uamt-brno/canshark/README.md

canshark
========

Wireshark sniffer for CAN bus
