uamt-brno/canshark/pcb/CanSharkV20/CanSharkV20.brd

## EAGLE design pcb/CanSharkV20/CanSharkV20.brd (2014-06-05)

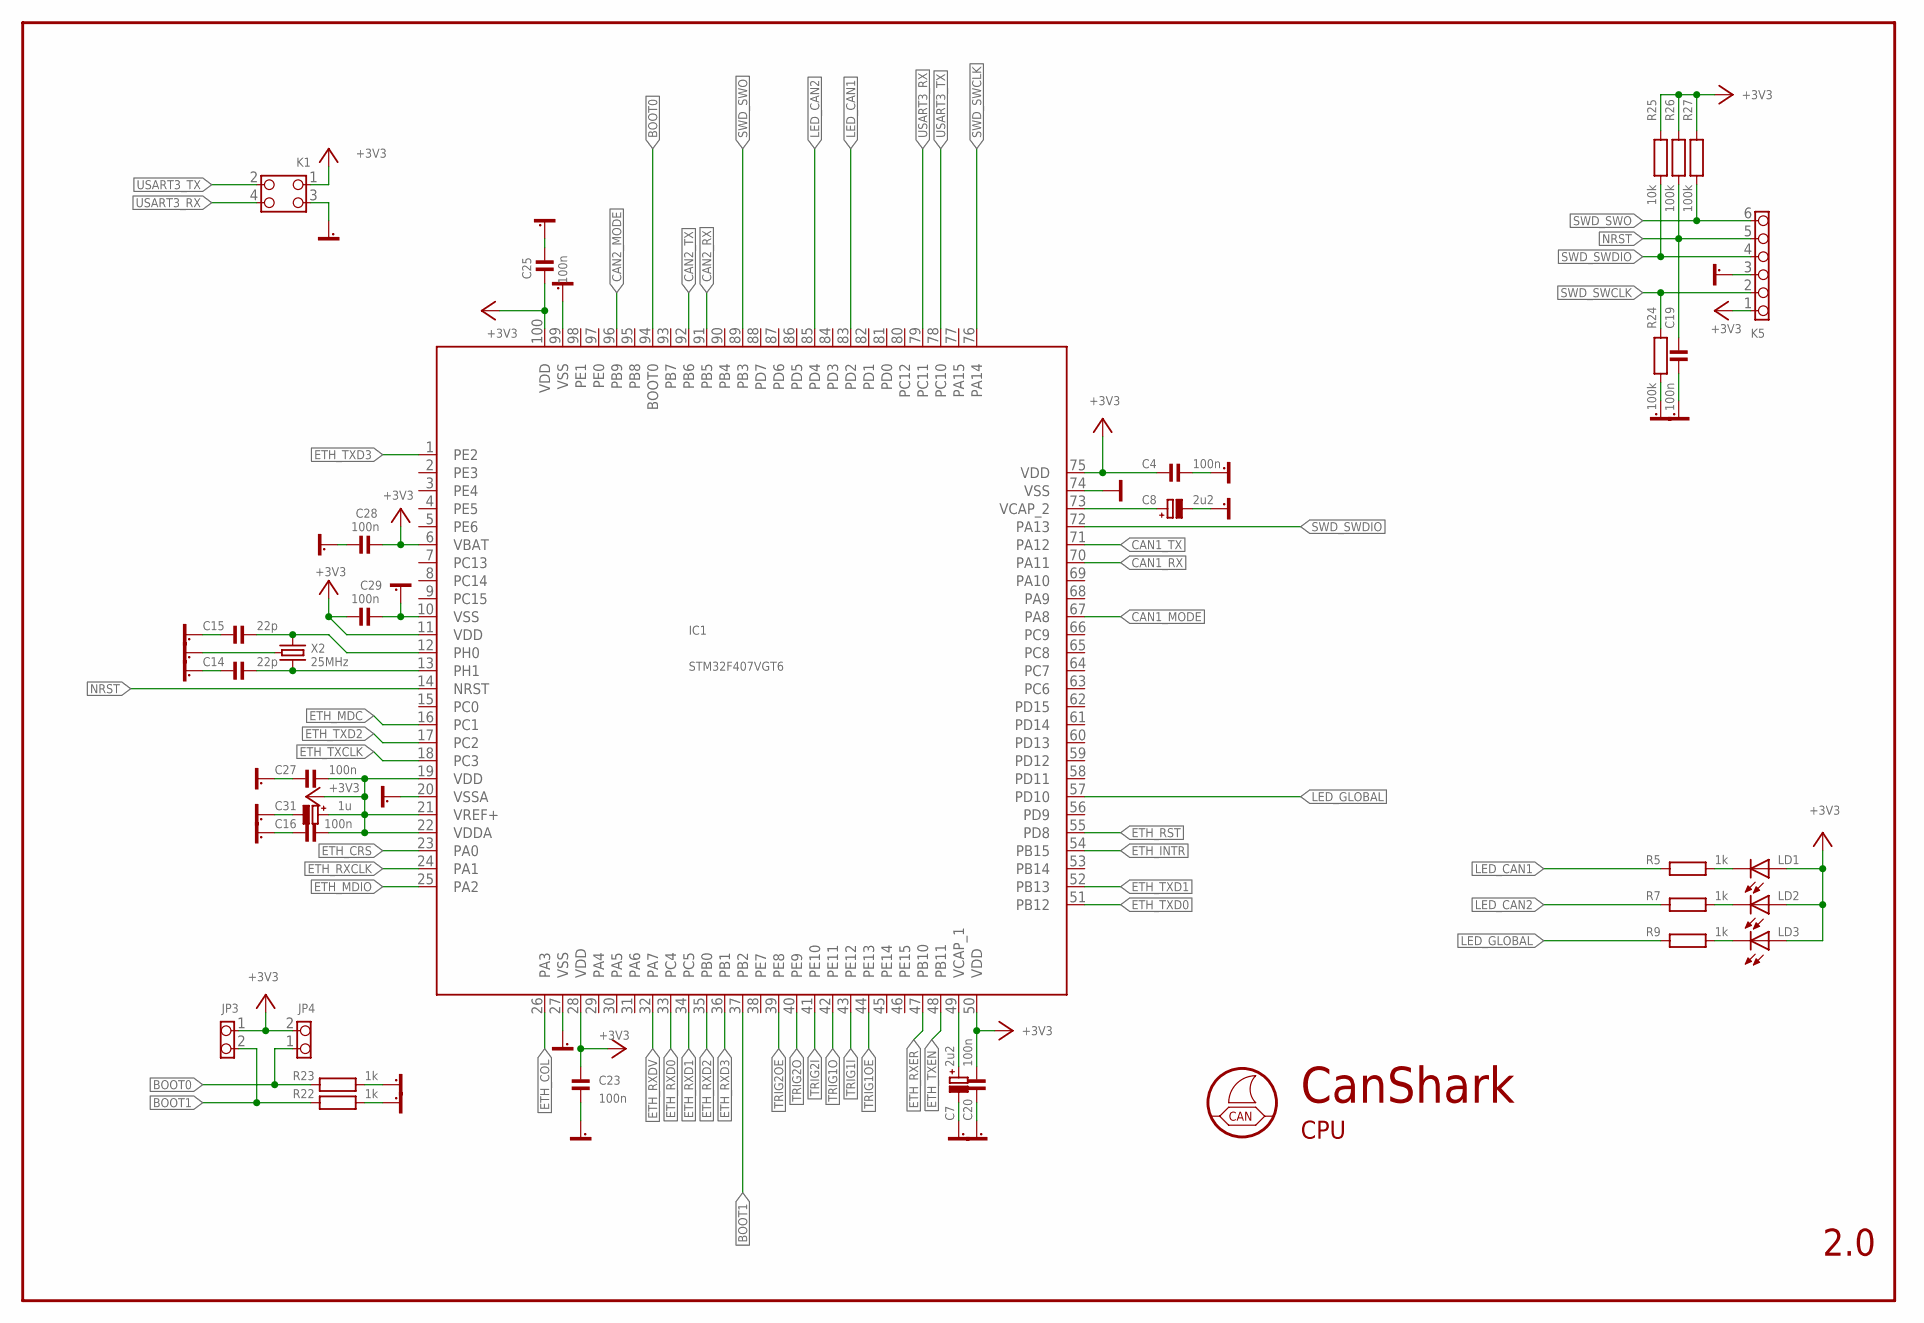
[picture p1: schematic CanSharkV20.sch, sheet 1]

Parts:
C4, C16, C19, C20, C23, C25, C27, C28, C29: 100n; 0603
C7, C8: 2u2; CT3216A
C14, C15: 22p; 0603
C31: 1u; CT3216A
IC1: STM32F407VGT6; LQFP100
JP3, JP4: PINHD-1X2; 1X02_254
K1: PINHD-2X2; 2X02_254
K5: PINHD-1X6; 1X06_254
LD1, LD2, LD3: TLLG4400; LED3MM
R5, R7, R9, R22, R23: 1k; 0603
R24, R25, R27: 100k; 0603
R26: 10k; 0603
X2: 25MHz; X_XT324

Connections:
+3V3: C4.2, C16.1, C20.1, C23.1, C25.2, C27.1, C28.2, C29.2, C31.+, IC1.6 (VBAT), IC1.11 (VDD), IC1.19 (VDD), IC1.21 (VREF+), IC1.22 (VDDA), IC1.28 (VDD), IC1.50 (VDD), IC1.75 (VDD), IC1.100 (VDD), JP3.1, JP4.2, K1.1, K5.1, LD1.A, LD2.A, LD3.A, R25.1, R26.2, R27.1; also elsewhere on the board
BOOT0: IC1.94 (BOOT0), JP4.1, R23.2
BOOT1: IC1.37 (PB2), JP3.2, R22.2
CAN1_MODE: IC1.67 (PA8); also elsewhere on the board
CAN1_RX: IC1.70 (PA11); also elsewhere on the board
CAN1_TX: IC1.71 (PA12); also elsewhere on the board
CAN2_MODE: IC1.96 (PB9); also elsewhere on the board
CAN2_RX: IC1.91 (PB5); also elsewhere on the board
CAN2_TX: IC1.92 (PB6); also elsewhere on the board
ETH_COL: IC1.26 (PA3); also elsewhere on the board
ETH_CRS: IC1.23 (PA0); also elsewhere on the board
ETH_INTR: IC1.54 (PB15); also elsewhere on the board
ETH_MDC: IC1.16 (PC1); also elsewhere on the board
ETH_MDIO: IC1.25 (PA2); also elsewhere on the board
ETH_RST: IC1.55 (PD8); also elsewhere on the board
ETH_RXCLK: IC1.24 (PA1); also elsewhere on the board
ETH_RXD0: IC1.33 (PC4); also elsewhere on the board
ETH_RXD1: IC1.34 (PC5); also elsewhere on the board
ETH_RXD2: IC1.35 (PB0); also elsewhere on the board
ETH_RXD3: IC1.36 (PB1); also elsewhere on the board
ETH_RXDV: IC1.32 (PA7); also elsewhere on the board
ETH_RXER: IC1.47 (PB10); also elsewhere on the board
ETH_TXCLK: IC1.18 (PC3); also elsewhere on the board
ETH_TXD0: IC1.51 (PB12); also elsewhere on the board
ETH_TXD1: IC1.52 (PB13); also elsewhere on the board
ETH_TXD2: IC1.17 (PC2); also elsewhere on the board
ETH_TXD3: IC1.1 (PE2); also elsewhere on the board
ETH_TXEN: IC1.48 (PB11); also elsewhere on the board
GND: IC1.74 (VSS)
GND1: C4.1, C7.-, C8.-, C14.2, C15.2, C16.2, C19.2, C20.2, C23.2, C25.1, C27.2, C28.1, C29.1, C31.-, IC1.10 (VSS), IC1.20 (VSSA), IC1.27 (VSS), IC1.99 (VSS), K1.3, K5.3, R22.1, R23.1, R24.2, X2.2 (G), X2.4 (G); also elsewhere on the board
LED_CAN1: IC1.83 (PD2), R5.2
LED_CAN2: IC1.85 (PD4), R7.2
LED_GLOBAL: IC1.57 (PD10), R9.2
unnamed: C7.+, IC1.49 (VCAP_1)
unnamed: C8.+, IC1.73 (VCAP_2)
unnamed: LD1.K (C), R5.1
unnamed: LD2.K (C), R7.1
unnamed: LD3.K (C), R9.1
NRST: C19.1, IC1.14 (NRST), K5.5, R26.1
OSC_IN: C15.1, IC1.12 (PH0), X2.1
OSC_OUT: C14.1, IC1.13 (PH1), X2.3 (2)
SWD_SWCLK: IC1.76 (PA14), K5.2, R24.1
SWD_SWDIO: IC1.72 (PA13), K5.4, R25.2
SWD_SWO: IC1.89 (PB3), K5.6, R27.2
TRIG1I: IC1.43 (PE12); also elsewhere on the board
TRIG1O: IC1.42 (PE11); also elsewhere on the board
TRIG1OE: IC1.44 (PE13); also elsewhere on the board
TRIG2I: IC1.41 (PE10); also elsewhere on the board
TRIG2O: IC1.40 (PE9); also elsewhere on the board
TRIG2OE: IC1.39 (PE8); also elsewhere on the board
USART3_RX: IC1.79 (PC11), K1.4
USART3_TX: IC1.78 (PC10), K1.2

Notes on the sheet:
CAN
2.0
CanShark
CPU

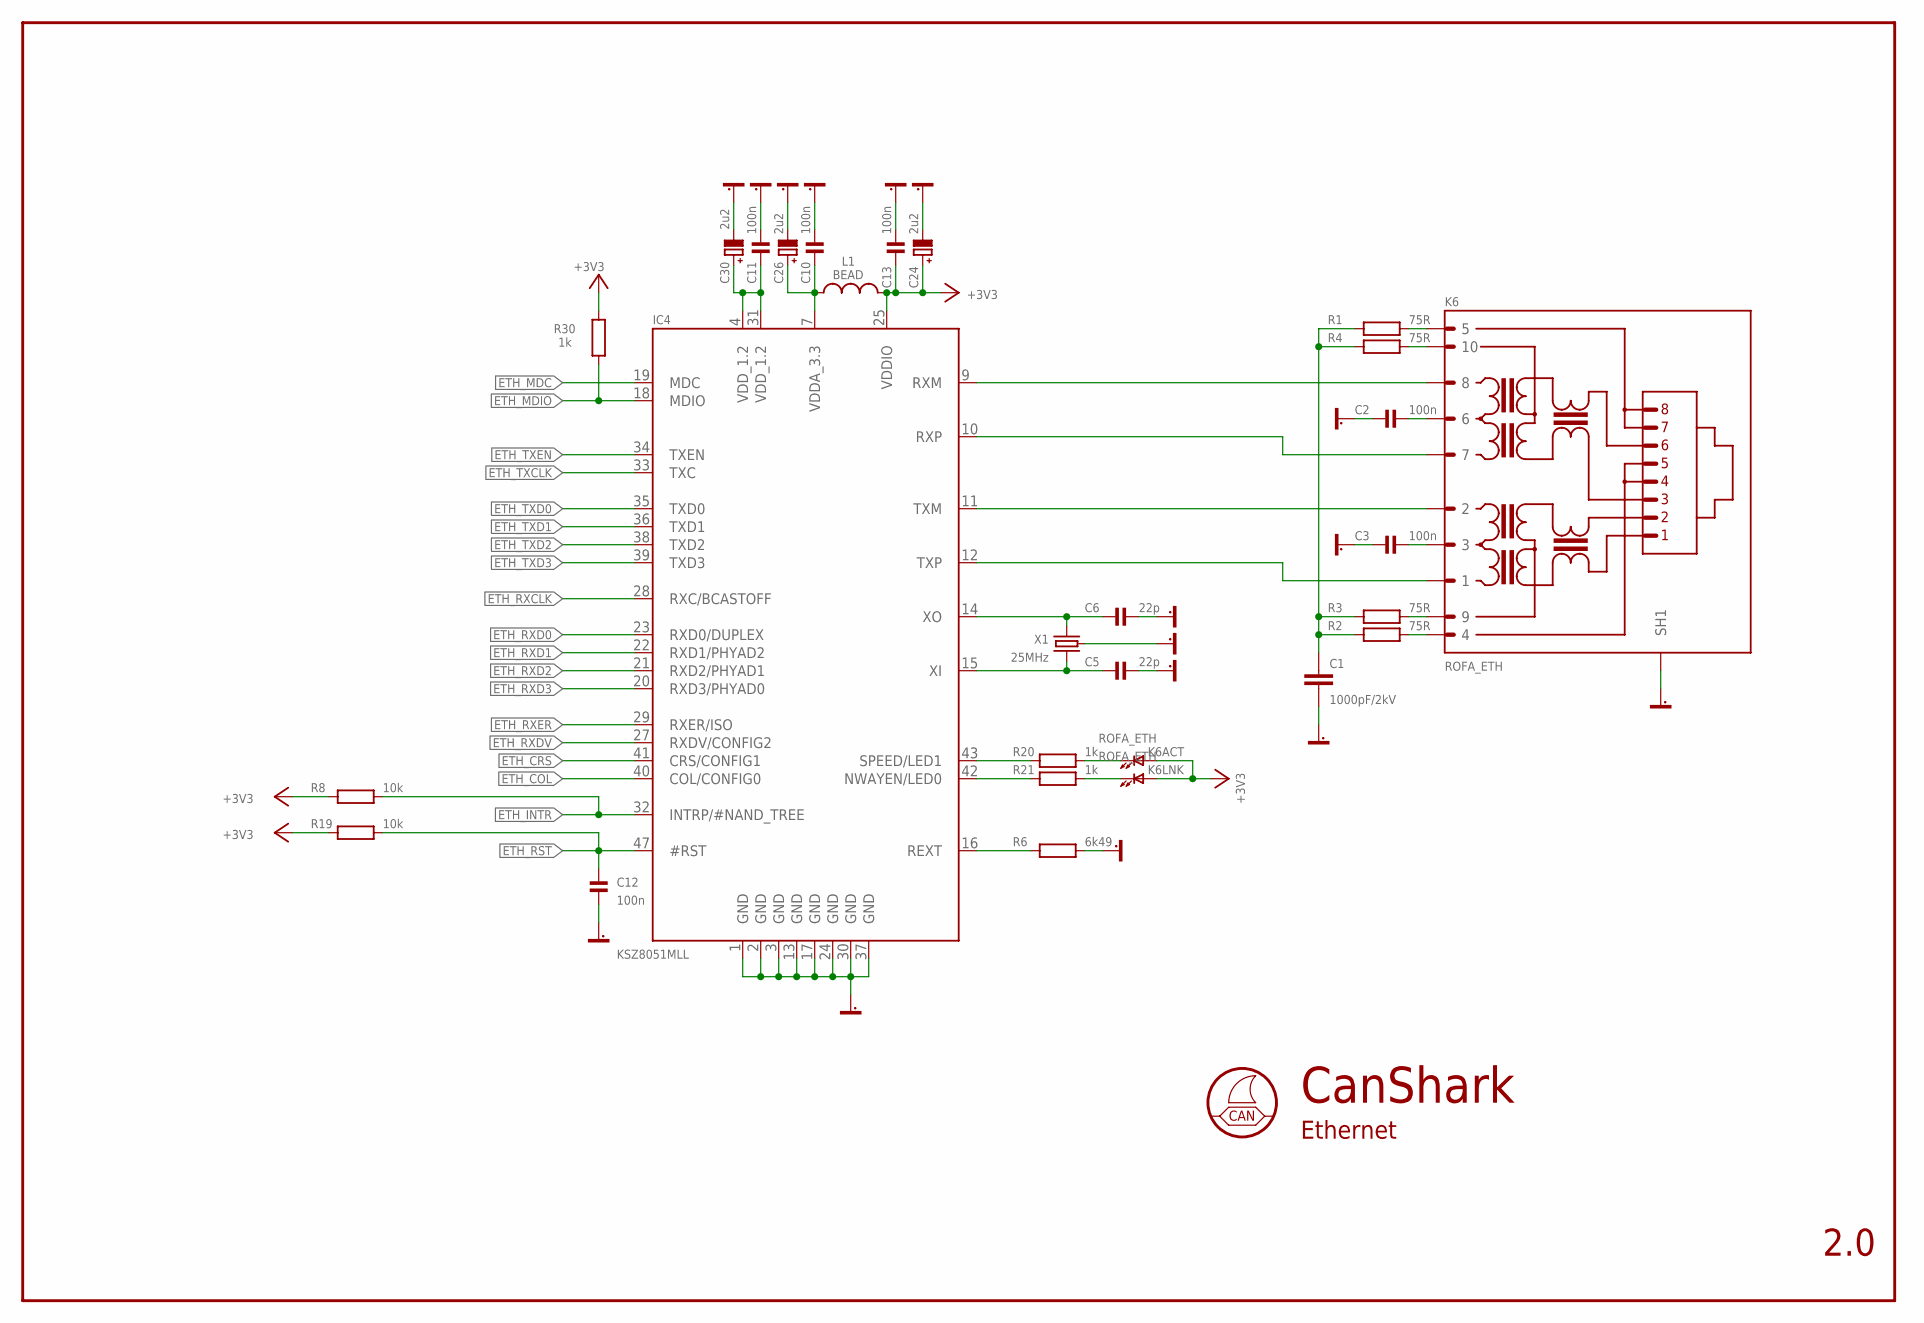
[picture p2: schematic CanSharkV20.sch, sheet 2]

Parts:
C1: 1000pF/2kV; SMD1206
C2, C3, C10, C11, C12, C13: 100n; 0603
C5, C6: 22p; 0603
C24, C26, C30: 2u2; CT3216A
IC4: KSZ8051MLL; LQFP48
K6: ROFA_ETH; RJ45_TRAFO
L1: BEAD; 1206
R1, R2, R3, R4: 75R; 0603
R6: 6k49; 0603
R8, R19: 10k; 0603
R20, R21, R30: 1k; 0603
X1: 25MHz; X_XT324

Connections:
+3V3: C13.2, C24.+, IC4.25 (VDDIO), K6.A_G (A), K6.A_Y (A), L1.1, R8.1, R19.1, R30.2; also elsewhere on the board
ETH_COL: IC4.40 (COL/CONFIG0); also elsewhere on the board
ETH_CRS: IC4.41 (CRS/CONFIG1); also elsewhere on the board
ETH_INTR: IC4.32 (INTRP/#NAND_TREE), R8.2; also elsewhere on the board
ETH_MDC: IC4.19 (MDC); also elsewhere on the board
ETH_MDIO: IC4.18 (MDIO), R30.1; also elsewhere on the board
ETH_RST: C12.1, IC4.47 (#RST), R19.2; also elsewhere on the board
ETH_RXCLK: IC4.28 (RXC/BCASTOFF); also elsewhere on the board
ETH_RXD0: IC4.23 (RXD0/DUPLEX); also elsewhere on the board
ETH_RXD1: IC4.22 (RXD1/PHYAD2); also elsewhere on the board
ETH_RXD2: IC4.21 (RXD2/PHYAD1); also elsewhere on the board
ETH_RXD3: IC4.20 (RXD3/PHYAD0); also elsewhere on the board
ETH_RXDV: IC4.27 (RXDV/CONFIG2); also elsewhere on the board
ETH_RXER: IC4.29 (RXER/ISO); also elsewhere on the board
ETH_TXCLK: IC4.33 (TXC); also elsewhere on the board
ETH_TXD0: IC4.35 (TXD0); also elsewhere on the board
ETH_TXD1: IC4.36 (TXD1); also elsewhere on the board
ETH_TXD2: IC4.38 (TXD2); also elsewhere on the board
ETH_TXD3: IC4.39 (TXD3); also elsewhere on the board
ETH_TXEN: IC4.34 (TXEN); also elsewhere on the board
GND1: C1.2, C2.1, C3.1, C5.1, C6.1, C10.1, C11.1, C12.2, C13.1, C24.-, C26.-, C30.-, IC4.1 (GND), IC4.2 (GND), IC4.3 (GND), IC4.13 (GND), IC4.17 (GND), IC4.24 (GND), IC4.30 (GND), IC4.37 (GND), K6.SH1, K6.SH2 (SH1), R6.1, X1.2 (G), X1.4 (G); also elsewhere on the board
unnamed: K6.K_Y (K), R20.2
unnamed: K6.K_G (K), R21.2
unnamed: C10.2, C26.+, IC4.7 (VDDA_3.3), L1.2
unnamed: C11.2, C30.+, IC4.4 (VDD_1.2), IC4.31 (VDD_1.2)
unnamed: IC4.9 (RXM), K6.8
unnamed: IC4.10 (RXP), K6.7
unnamed: IC4.11 (TXM), K6.2
unnamed: IC4.12 (TXP), K6.1
unnamed: K6.4, R2.2
unnamed: K6.9, R3.2
unnamed: K6.10, R4.2
unnamed: K6.5, R1.2
unnamed: C1.1, R1.1, R2.1, R3.1, R4.1
unnamed: C2.2, K6.6
unnamed: C3.2, K6.3
unnamed: IC4.16 (REXT), R6.2
unnamed: IC4.42 (NWAYEN/LED0), R21.1
unnamed: IC4.43 (SPEED/LED1), R20.1
unnamed: C6.2, IC4.14 (XO), X1.3 (2)
unnamed: C5.2, IC4.15 (XI), X1.1

Notes on the sheet:
CAN
2.0
CanShark
Ethernet

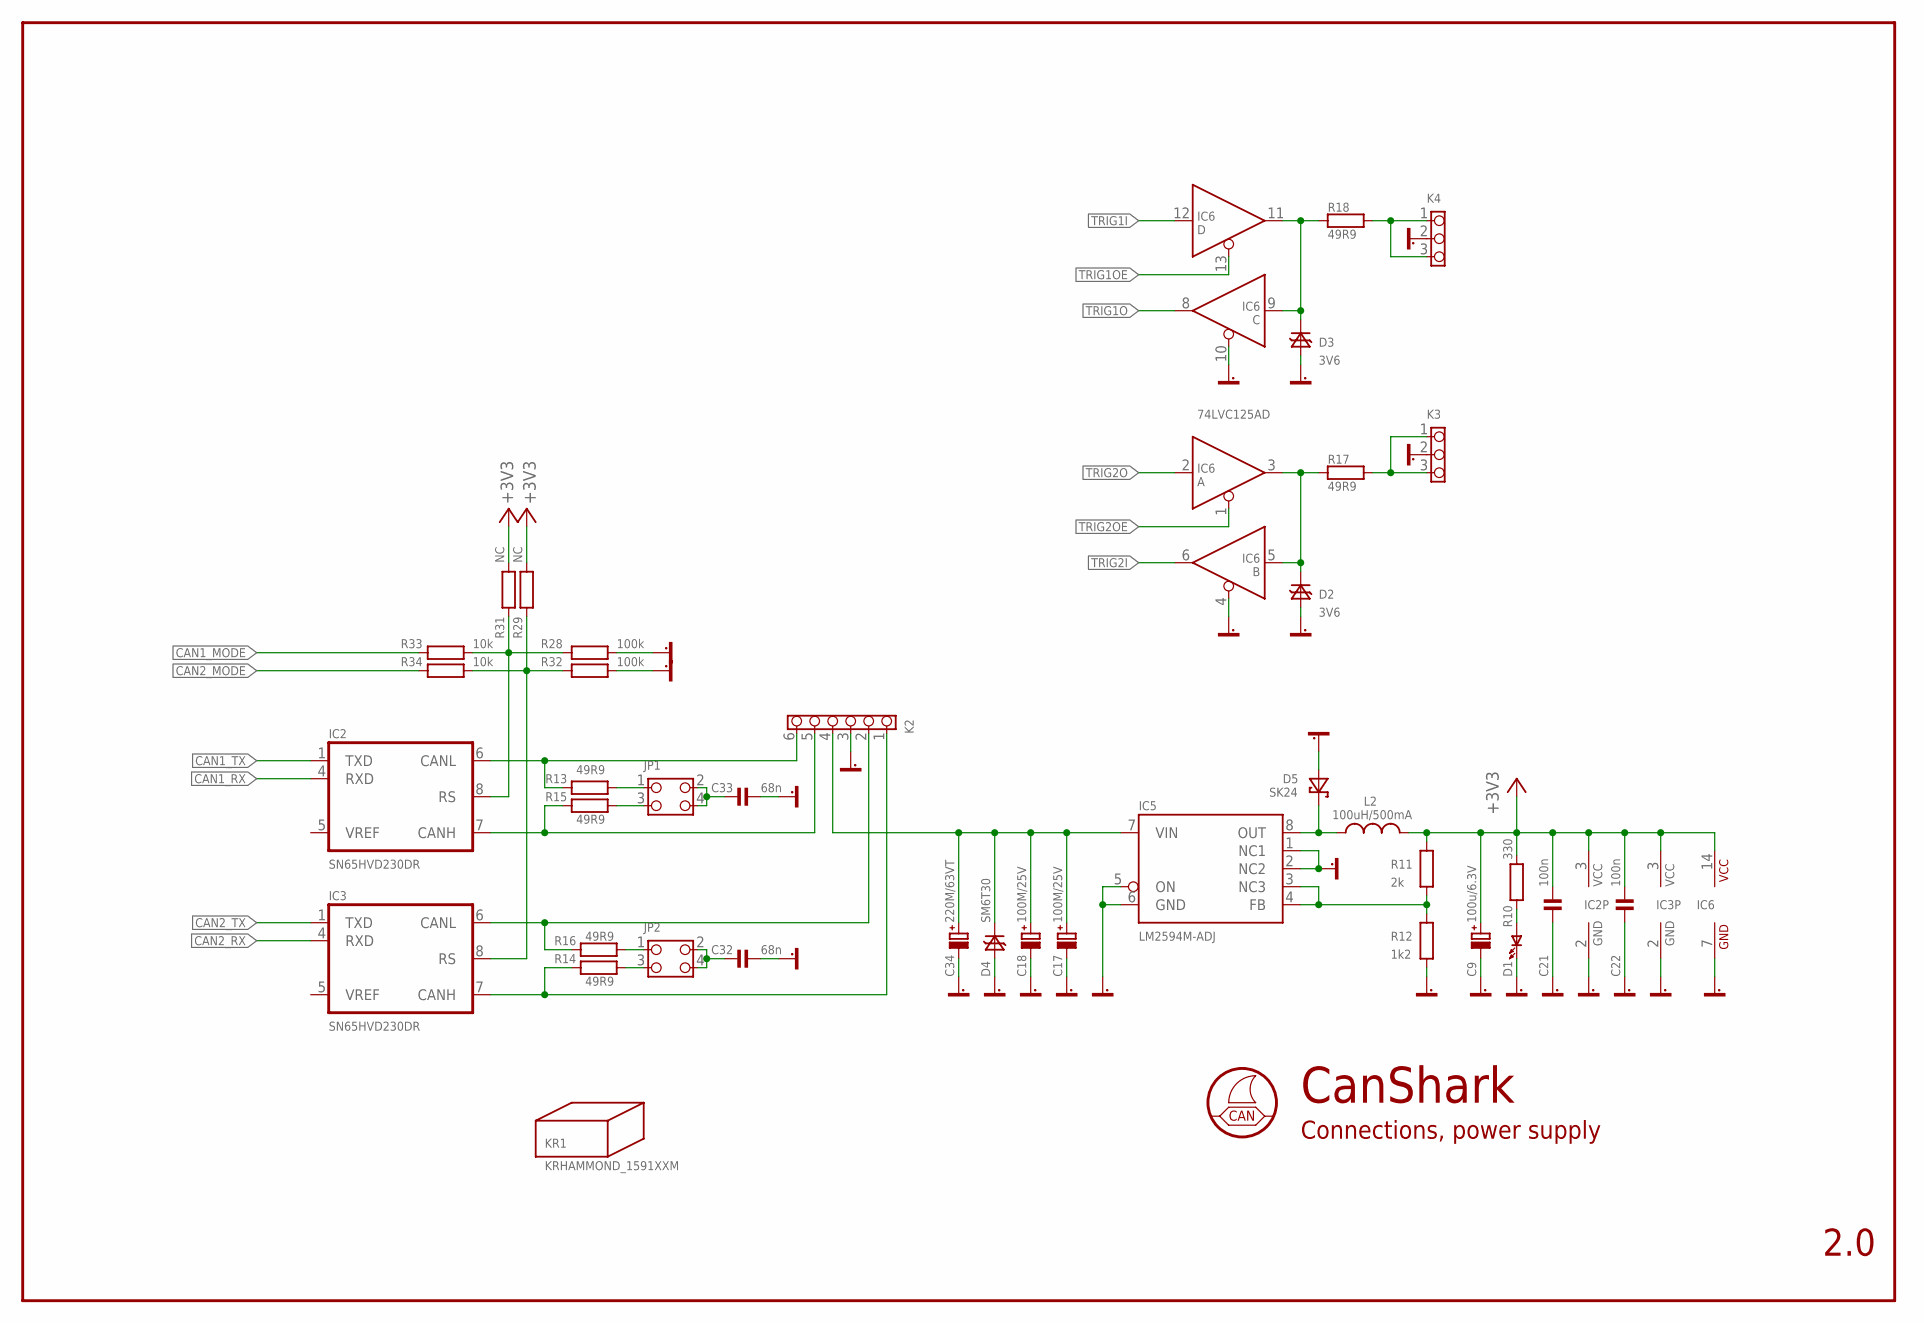
[picture p3: schematic CanSharkV20.sch, sheet 3]

Parts:
C9: 100u/6.3V; CT3528B
C17, C18: 100M/25V; CT7343D
C21, C22: 100n; 0603
C32, C33: 68n; 0805
C34: 220M/63VT; CE_D10L13_R
D1: LED0805; LED_0805
D2, D3: 3V6; D_SMA
D4: SM6T30; D_SMB
D5: SK24; D_SMB
IC2, IC3: SN65HVD230DR; SO08
IC5: LM2594M-ADJ; SO08
IC6: 74LVC125AD; SO14
JP1, JP2: PINHD-2X2_254_EDGE; 2X02_254_EDGE
K2: PINHD-1X6_381_V; 1X06_381_V
K3, K4: PINHD-1X3; 1X03_254
KR1: KRHAMMOND_1591XXM; HAMMOND_1591XXM
L2: 100uH/500mA; L_MLC12XX
R10: 330; 0603
R11: 2k; 0603
R12: 1k2; 0603
R13, R14, R15, R16, R17, R18: 49R9; 0805
R28, R32: 100k; 0603
R29, R31: NC; 0603
R33, R34: 10k; 0603

Connections:
+3V3: C9.+, C21.1, C22.1, IC2.3 (VCC), IC3.3 (VCC), IC6.14 (VCC), L2.2 (1), R10.1, R11.1, R29.1, R31.1; also elsewhere on the board
CAN1_H: IC2.7 (CANH), K2.5, R15.2
CAN1_L: IC2.6 (CANL), K2.6, R13.2
CAN1_MODE: R33.1; also elsewhere on the board
CAN1_RX: IC2.4 (RXD); also elsewhere on the board
CAN1_TX: IC2.1 (TXD); also elsewhere on the board
CAN2_H: IC3.7 (CANH), K2.1, R14.2
CAN2_L: IC3.6 (CANL), K2.2, R16.2
CAN2_MODE: R34.1; also elsewhere on the board
CAN2_RX: IC3.4 (RXD); also elsewhere on the board
CAN2_TX: IC3.1 (TXD); also elsewhere on the board
EXTSUPPLY: C17.+, C18.+, C34.P (+), D4.K, IC5.7 (VIN), K2.4
GND1: C9.-, C17.-, C18.-, C21.2, C22.2, C32.1, C33.1, C34.M (-), D1.K (C), D2.A, D3.A, D4.A, D5.A, IC2.2 (GND), IC3.2 (GND), IC5.1 (NC1), IC5.2 (NC2), IC5.5 (ON), IC5.6 (GND), IC6.4 (OE), IC6.7 (GND), IC6.10 (OE), K2.3, K3.2, K4.2, R12.2, R28.2, R32.2; also elsewhere on the board
unnamed: D2.K, IC6.3 (Y), IC6.5 (A), R17.1
unnamed: JP2.1, R16.1
unnamed: D1.A, R10.2
unnamed: JP2.3, R14.1
unnamed: C32.2, JP2.2, JP2.4
unnamed: IC2.8 (RS), R28.1, R31.2, R33.2
unnamed: JP1.1, R13.1
unnamed: IC3.8 (RS), R29.2, R32.1, R34.2
unnamed: JP1.3, R15.1
unnamed: C33.2, JP1.2, JP1.4
unnamed: K4.1, K4.3, R18.2
unnamed: K3.1, K3.3, R17.2
unnamed: D5.K, IC5.8 (OUT), L2.1 (2)
unnamed: IC5.3 (NC3), IC5.4 (FB), R11.2, R12.1
unnamed: D3.K, IC6.9 (A), IC6.11 (Y), R18.1
TRIG1I: IC6.12 (A); also elsewhere on the board
TRIG1O: IC6.8 (Y); also elsewhere on the board
TRIG1OE: IC6.13 (OE); also elsewhere on the board
TRIG2I: IC6.6 (Y); also elsewhere on the board
TRIG2O: IC6.2 (A); also elsewhere on the board
TRIG2OE: IC6.1 (OE); also elsewhere on the board

Notes on the sheet:
CAN
2.0
CanShark
Connections, power supply

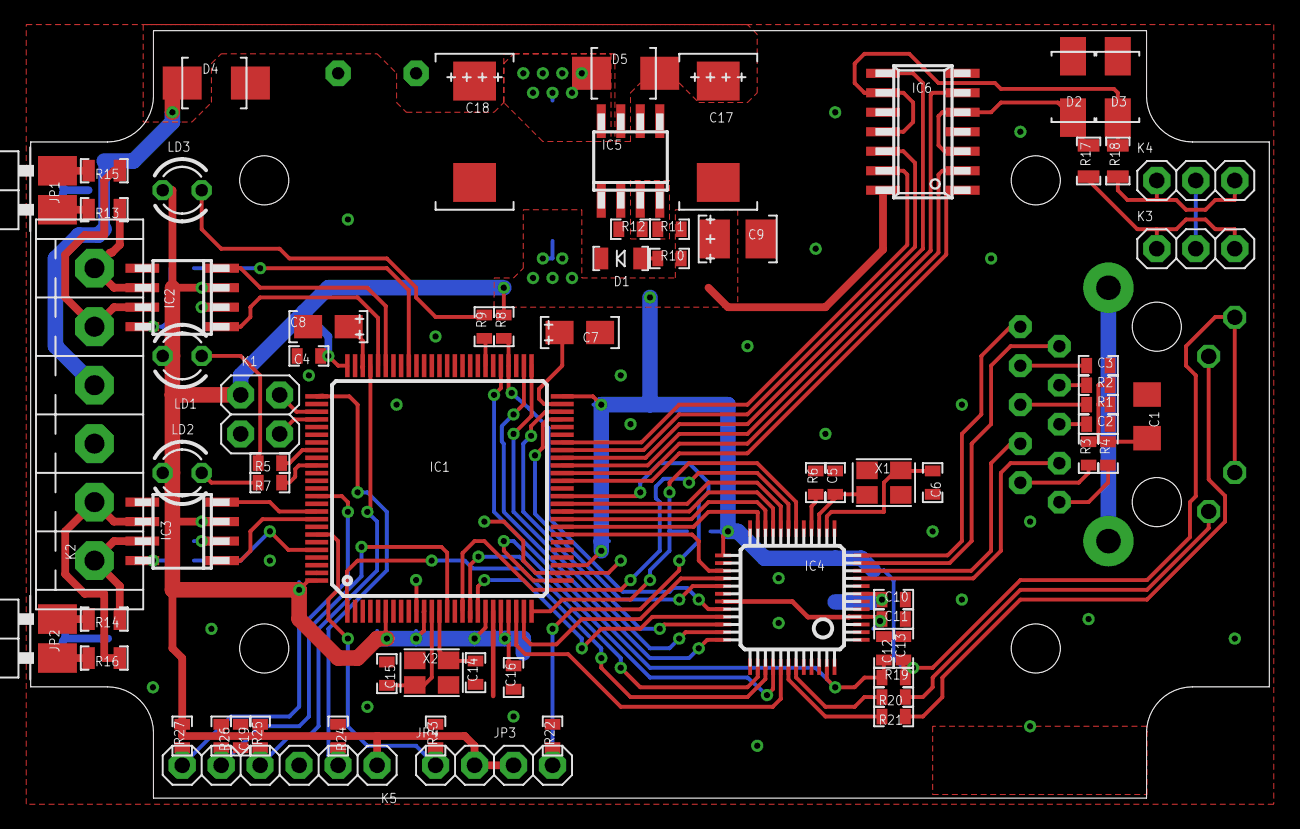
[picture p4: board CanSharkV20.brd from above]

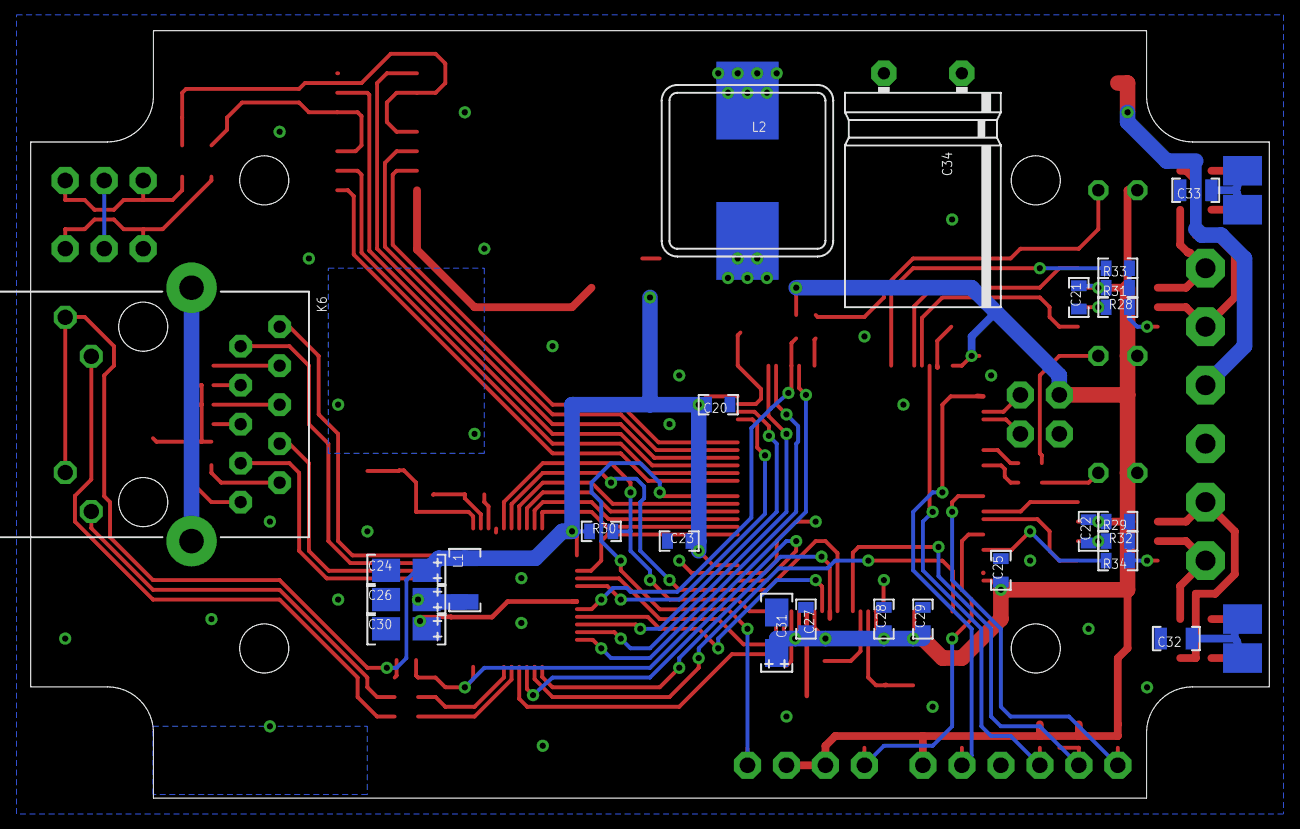
[picture p5: board CanSharkV20.brd from below]

Board: 2 copper layers, 80.7 x 50.0 mm, 97 parts (25 on the bottom side), 91 nets.
