uamt-brno/canshark/pcb/F407-v10/CanShark.brd

## EAGLE design pcb/F407-v10/CanShark.brd (2014-06-02)

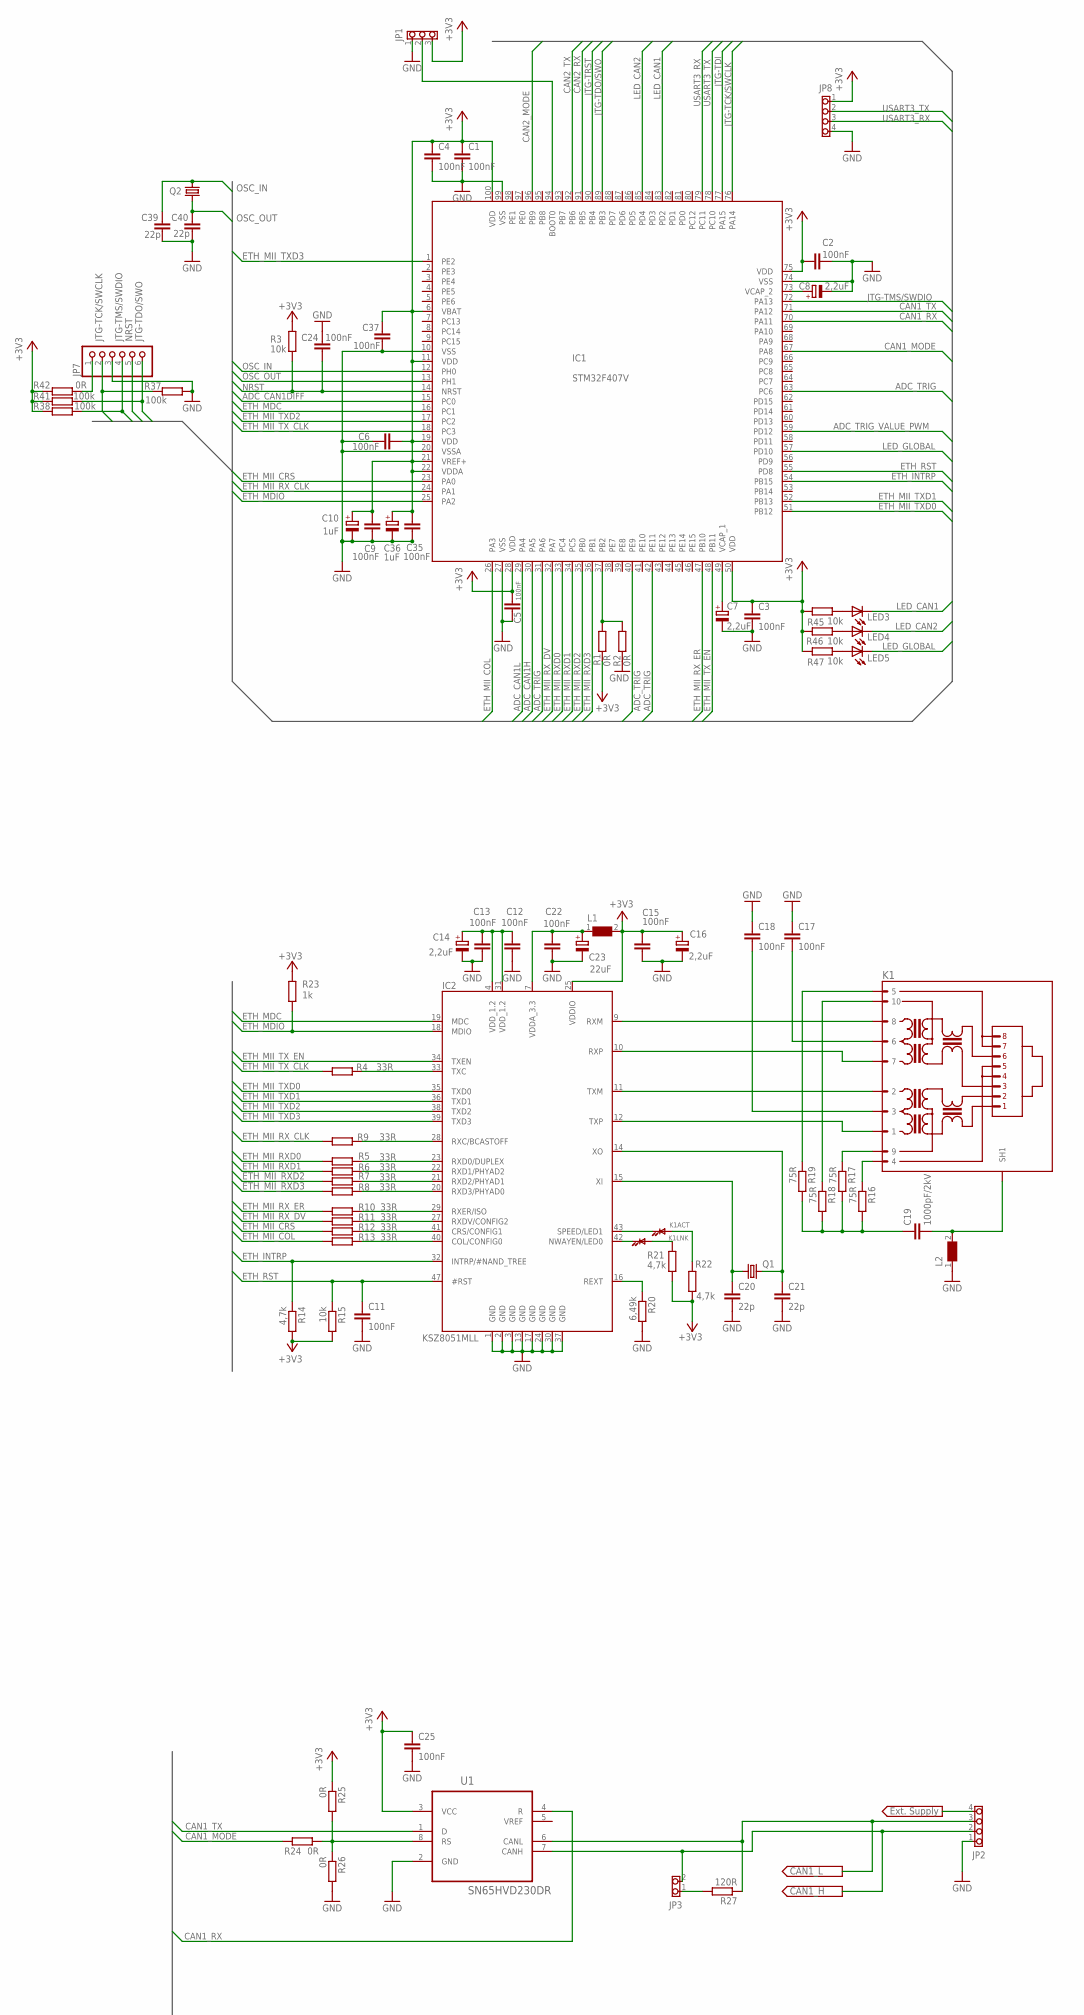
[picture p6: schematic CanShark.sch, part in row 1, column 1]

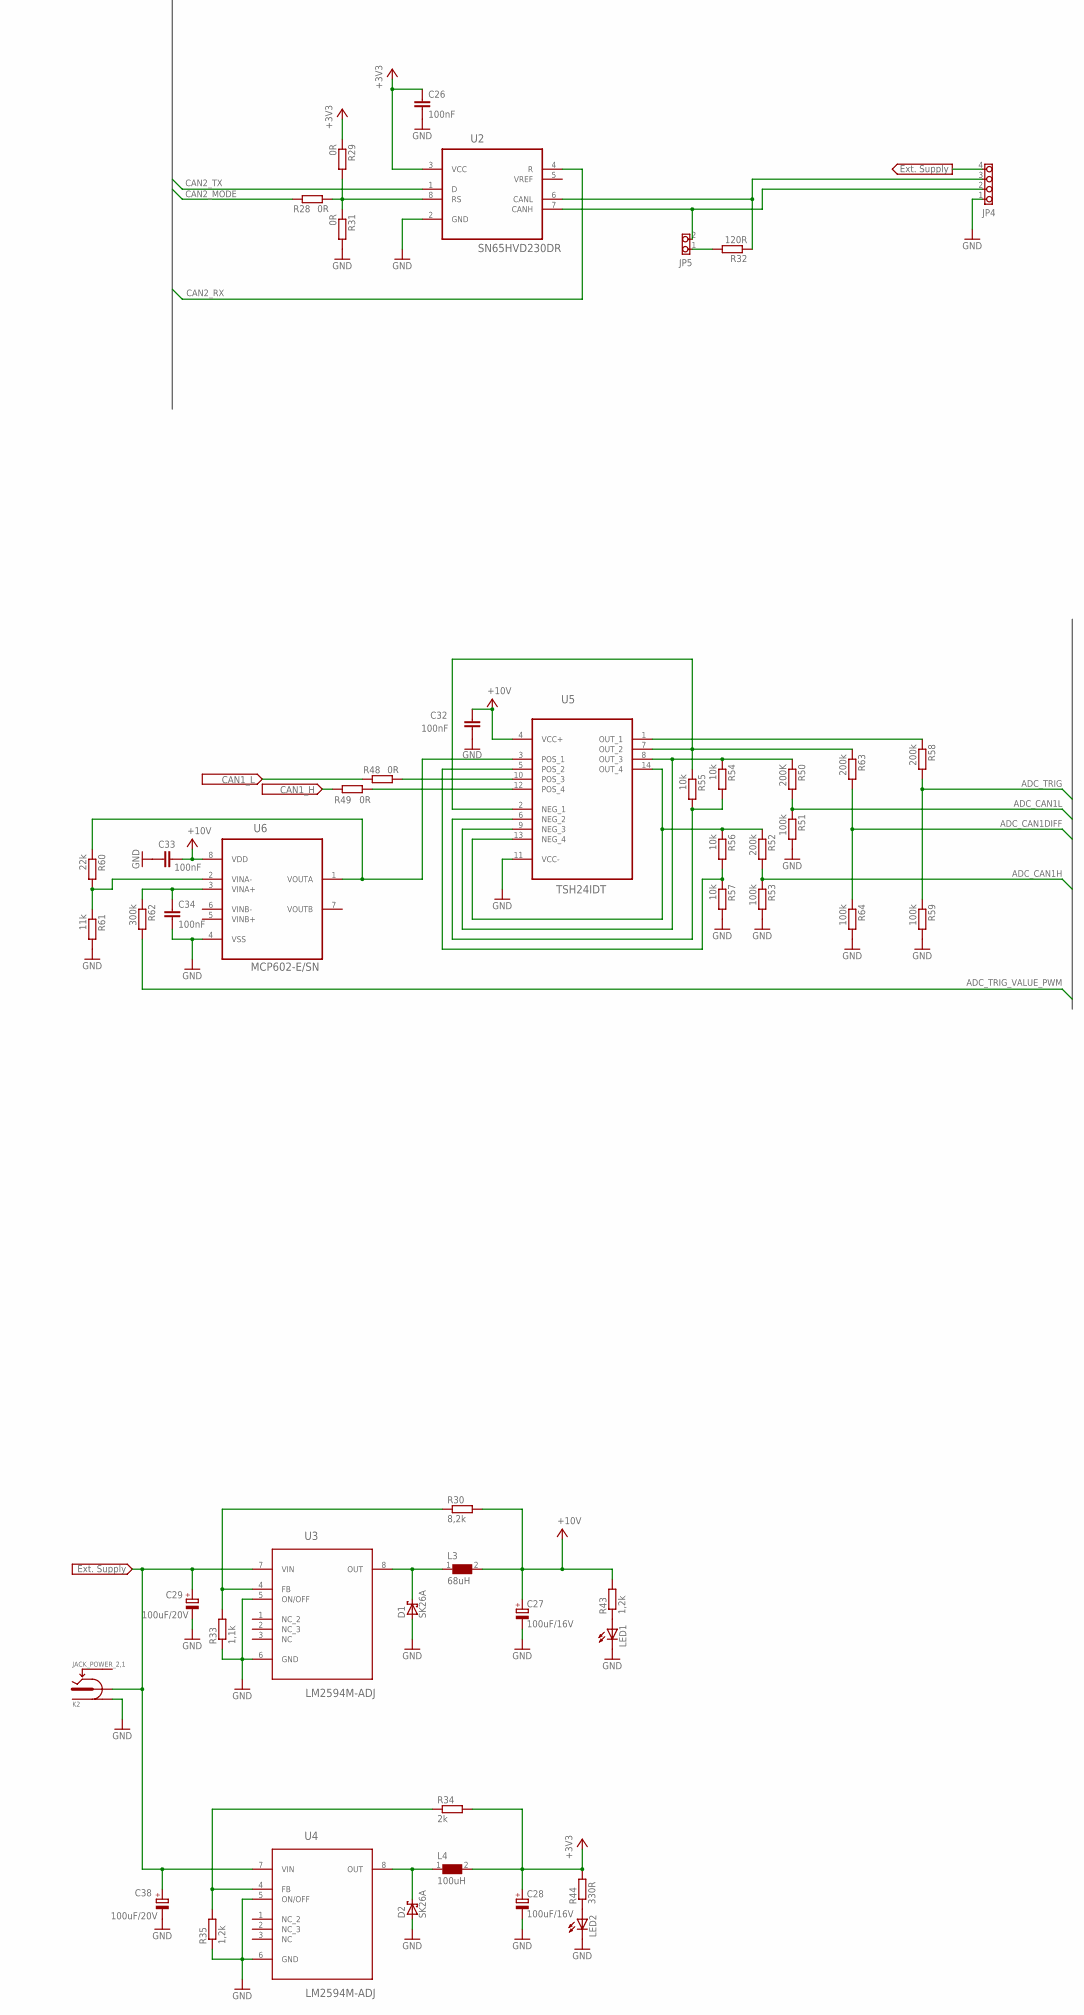
[picture p7: schematic CanShark.sch, part in row 2, column 1]

Parts:
C1, C2, C3, C4, C5, C6, C9, C11, C12, C13, C15, C17, C18, C22, C24, C25, C26, C32, C33, C34, C35, C37: 100nF; SMD0603
C7, C8, C14, C16: 2,2uF; SMC_A
C10, C36: 1uF; SMC_A
C19: 1000pF/2kV; SMD1206
C20, C21, C39, C40: 22p; SMD0603
C23: 22uF; SMC_A
C27, C28: 100uF/16V; C/6032-28R
C29, C38: 100uF/20V; C/6032-28R
D1, D2: SK26A; SMB
IC1: STM32F407V; LQFP100
IC2: KSZ8051MLL; LQFP48
JP1: PINHD-1X3; 1X03_254
JP2, JP4: PINHD-1X4_508_H; 1X04_508_H
JP3, JP5: PINHD-1X2; 1X02_254
JP7: PINHD-1X6; 1X06
JP8: PINHD-1X4; 1X04_254
K1: RJ45_TRAFO
K2: JACK_POWER_2,1; J_P_2,1
L1, L2: WE-CBF_HF-742863122_0603; 0603
L3: 68uH; WE-TPC_1028/1038
L4: 100uH; WE-TPC_1028/1038
LED1, LED2: LEDSML0603; SML0603
LED3, LED4, LED5: TLLG4400; LED3MM
Q1, Q2: CRYSTALHC49U-V; HC49U-V
R1, R2, R24, R25, R26, R28, R29, R31, R42, R48, R49: 0R; R0603
R3, R15, R45, R46, R47, R54, R55, R56, R57: 10k; R0603
R4, R5, R6, R7, R8, R9, R10, R11, R12, R13: 33R; R0603
R14, R21, R22: 4,7k; R0603
R16, R17, R18, R19: 75R; R0603
R20: 6,49k; R0603
R23: 1k; R0603
R27, R32: 120R; R0603
R30: 8,2k; R0603
R33: 1,1k; R0603
R34: 2k; R0603
R35, R43: 1,2k; R0603
R37, R38, R41, R51, R53, R59, R64: 100k; R0603
R44: 330R; R0603
R50: 200K; R0603
R52, R58, R63: 200k; R0603
R60: 22k; R0603
R61: 11k; R0603
R62: 300k; R0603
U1, U2: SN65HVD230DR; SOIC127P600X175-8N
U3, U4: LM2594M-ADJ; SOIC127P620X175-8N
U5: TSH24IDT; SOIC127P600X175-14N
U6: MCP602-E/SN; SOIC127P600X175-8N

Connections:
+3V3: C1.1, C2.1, C3.1, C4.1, C5.1, C6.2, C9.2, C10.+, C15.1, C16.+, C25.1, C26.1, C28.+, C35.2, C36.+, C37.2, IC1.6 (VBAT), IC1.11 (VDD), IC1.19 (VDD), IC1.21 (VREF+), IC1.22 (VDDA), IC1.28 (VDD), IC1.50 (VDD), IC1.75 (VDD), IC1.100 (VDD), IC2.25 (VDDIO), JP1.3, JP8.1, L1.2, L4.2, R1.1, R3.2, R14.2, R15.2, R21.1, R22.1, R23.1, R25.1, R29.1, R34.2, R38.1, R41.1, R42.1, R44.2, R45.2, R46.2, R47.2, U1.3 (VCC), U2.3 (VCC)
ADC_CAN1DIFF: IC1.15 (PC0), R63.2, R64.1
ADC_CAN1H: IC1.30 (PA5), R52.2, R53.1
ADC_CAN1L: IC1.29 (PA4), R50.2, R51.1
ADC_TRIG: IC1.31 (PA6), IC1.40 (PE9), IC1.42 (PE11), IC1.63 (PC6), R58.2, R59.1
ADC_TRIG_VALUE_PWM: IC1.59 (PD12), R62.2
CAN1_H: JP2.2, JP3.2, R49.2, U1.7 (CANH)
CAN1_L: JP2.3, R27.1, R48.2, U1.6 (CANL)
CAN1_MODE: IC1.67 (PA8), R24.1
CAN1_RX: IC1.70 (PA11), U1.4 (R)
CAN1_TX: IC1.71 (PA12), U1.1 (D)
CAN2_MODE: IC1.96 (PB9), R28.1
CAN2_RX: IC1.91 (PB5), U2.4 (R)
CAN2_TX: IC1.92 (PB6), U2.1 (D)
CANL: JP4.3, R32.1, U2.6 (CANL)
ETH_INTRP: IC1.54 (PB15), IC2.32 (INTRP/#NAND_TREE), R14.1
ETH_MDC: IC1.16 (PC1), IC2.19 (MDC)
ETH_MDIO: IC1.25 (PA2), IC2.18 (MDIO), R23.2
ETH_MII_COL: IC1.26 (PA3), R13.2
ETH_MII_CRS: IC1.23 (PA0), R12.2
ETH_MII_RXD0: IC1.33 (PC4), R5.2
ETH_MII_RXD1: IC1.34 (PC5), R6.2
ETH_MII_RXD2: IC1.35 (PB0), R7.2
ETH_MII_RXD3: IC1.36 (PB1), R8.2
ETH_MII_RX_CLK: IC1.24 (PA1), R9.2
ETH_MII_RX_DV: IC1.32 (PA7), R11.2
ETH_MII_RX_ER: IC1.47 (PB10), R10.2
ETH_MII_TXD0: IC1.51 (PB12), IC2.35 (TXD0)
ETH_MII_TXD1: IC1.52 (PB13), IC2.36 (TXD1)
ETH_MII_TXD2: IC1.17 (PC2), IC2.38 (TXD2)
ETH_MII_TXD3: IC1.1 (PE2), IC2.39 (TXD3)
ETH_MII_TX_CLK: IC1.18 (PC3), R4.2
ETH_MII_TX_EN: IC1.48 (PB11), IC2.34 (TXEN)
ETH_RST: C11.1, IC1.55 (PD8), IC2.47 (#RST), R15.1
EXTSUPPLY: C29.+, C38.+, JP2.4, JP4.4, K2.A, U3.7 (VIN), U4.7 (VIN)
GND: C1.2, C2.2, C3.2, C4.2, C5.2, C6.1, C7.-, C8.-, C9.1, C10.-, C11.2, C12.2, C13.2, C14.-, C15.2, C16.-, C17.1, C18.1, C20.2, C21.2, C22.2, C23.-, C24.2, C25.2, C26.2, C27.-, C28.-, C29.-, C32.2, C33.2, C34.2, C35.1, C36.-, C37.1, C38.-, C39.2, C40.2, D1.A, D2.A, IC1.10 (VSS), IC1.20 (VSSA), IC1.27 (VSS), IC1.74 (VSS), IC1.99 (VSS), IC2.1 (GND), IC2.2 (GND), IC2.3 (GND), IC2.13 (GND), IC2.17 (GND), IC2.24 (GND), IC2.30 (GND), IC2.37 (GND), JP1.1, JP2.1, JP4.1, JP7.3, JP8.4, K2.B, L2.1, LED1.C, LED2.C, R2.1, R20.2, R26.2, R31.2, R33.1, R35.1, R37.2, R51.2, R53.2, R57.2, R59.2, R61.2, R64.2, U1.2 (GND), U2.2 (GND), U3.5 (ON/OFF), U3.6 (GND), U4.5 (ON/OFF), U4.6 (GND), U5.11 (VCC-), U6.4 (VSS)
JTG-TCK/SWCLK: IC1.76 (PA14), JP7.2, R37.1
JTG-TDI: IC1.77 (PA15)
JTG-TDO/SWO: IC1.89 (PB3), JP7.6, R41.2
JTG-TMS/SWDIO: IC1.72 (PA13), JP7.4, R38.2
JTG-TRST: IC1.90 (PB4)
LED_CAN1: IC1.83 (PD2), LED3.K (C)
LED_CAN2: IC1.85 (PD4), LED4.K (C)
LED_GLOBAL: IC1.57 (PD10), LED5.K (C)
unnamed: IC1.94 (BOOT0), JP1.2
unnamed: C7.+, IC1.49 (VCAP_1)
unnamed: C8.+, IC1.73 (VCAP_2)
unnamed: JP3.1, R27.2
unnamed: IC1.37 (PB2), R1.2, R2.2
unnamed: D1.C, L3.1, U3.8 (OUT)
unnamed: C22.1, C23.+, IC2.7 (VDDA_3.3), L1.1
unnamed: IC2.33 (TXC), R4.1
unnamed: R24.2, R25.2, R26.1, U1.8 (RS)
unnamed: JP4.2, JP5.2, U2.7 (CANH)
unnamed: IC2.28 (RXC/BCASTOFF), R9.1
unnamed: R28.2, R29.2, R31.1, U2.8 (RS)
unnamed: IC2.23 (RXD0/DUPLEX), R5.1
unnamed: IC2.22 (RXD1/PHYAD2), R6.1
unnamed: IC2.21 (RXD2/PHYAD1), R7.1
unnamed: IC2.20 (RXD3/PHYAD0), R8.1
unnamed: IC2.29 (RXER/ISO), R10.1
unnamed: IC2.27 (RXDV/CONFIG2), R11.1
unnamed: IC2.41 (CRS/CONFIG1), R12.1
unnamed: IC2.40 (COL/CONFIG0), R13.1
unnamed: JP5.1, R32.2
unnamed: JP7.1, R42.2
unnamed: D2.C, L4.1, U4.8 (OUT)
unnamed: R34.1, R35.2, U4.4 (FB)
unnamed: R30.1, R33.2, U3.4 (FB)
unnamed: LED1.A, R43.1
unnamed: C12.1, C13.1, C14.+, IC2.4 (VDD_1.2), IC2.31 (VDD_1.2)
unnamed: IC2.9 (RXM), K1.8
unnamed: IC2.10 (RXP), K1.7
unnamed: IC2.11 (TXM), K1.2
unnamed: IC2.12 (TXP), K1.1
unnamed: K1.4, R16.1
unnamed: K1.9, R17.1
unnamed: K1.10, R18.1
unnamed: K1.5, R19.1
unnamed: C19.1, R16.2, R17.2, R18.2, R19.2
unnamed: C17.2, K1.6
unnamed: C18.2, K1.3
unnamed: C19.2, K1.SH1, K1.SH2 (SH1), L2.2
unnamed: IC2.16 (REXT), R20.1
unnamed: IC2.42 (NWAYEN/LED0), K1.K_G (K)
unnamed: IC2.43 (SPEED/LED1), K1.K_Y (K)
unnamed: K1.A_Y (A), R22.2
unnamed: K1.A_G (A), R21.2
unnamed: LED2.A, R44.1
unnamed: C21.1, IC2.14 (XO), Q1.2
unnamed: C20.1, IC2.15 (XI), Q1.1
unnamed: LED3.A, R45.1
unnamed: LED4.A, R46.1
unnamed: LED5.A, R47.1
unnamed: R52.1, R56.1, U5.13 (NEG_4), U5.14 (OUT_4)
unnamed: R50.1, R54.1, U5.8 (OUT_3), U5.9 (NEG_3)
unnamed: R49.1, U5.12 (POS_4)
unnamed: R48.1, U5.10 (POS_3)
unnamed: R55.1, R63.1, U5.2 (NEG_1), U5.7 (OUT_2)
unnamed: R54.2, R55.2, U5.6 (NEG_2)
unnamed: R56.2, R57.1, U5.5 (POS_2)
unnamed: R60.1, U5.3 (POS_1), U6.1 (VOUTA)
unnamed: R58.1, U5.1 (OUT_1)
unnamed: R60.2, R61.1, U6.2 (VINA-)
unnamed: C34.1, R62.1, U6.3 (VINA+)
NRST: C24.1, IC1.14 (NRST), JP7.5, R3.1
OSC_IN: C39.1, IC1.12 (PH0), Q2.2
OSC_OUT: C40.1, IC1.13 (PH1), Q2.1
USART3_RX: IC1.79 (PC11), JP8.3
USART3_TX: IC1.78 (PC10), JP8.2
V+: C27.+, C32.1, C33.1, L3.2, R30.2, R43.2, U5.4 (VCC+), U6.8 (VDD)
