uamt-brno/canshark/pcb/F407-v10/CanShark.brd

## EAGLE design pcb/F407-v10/CanShark.brd (continued)

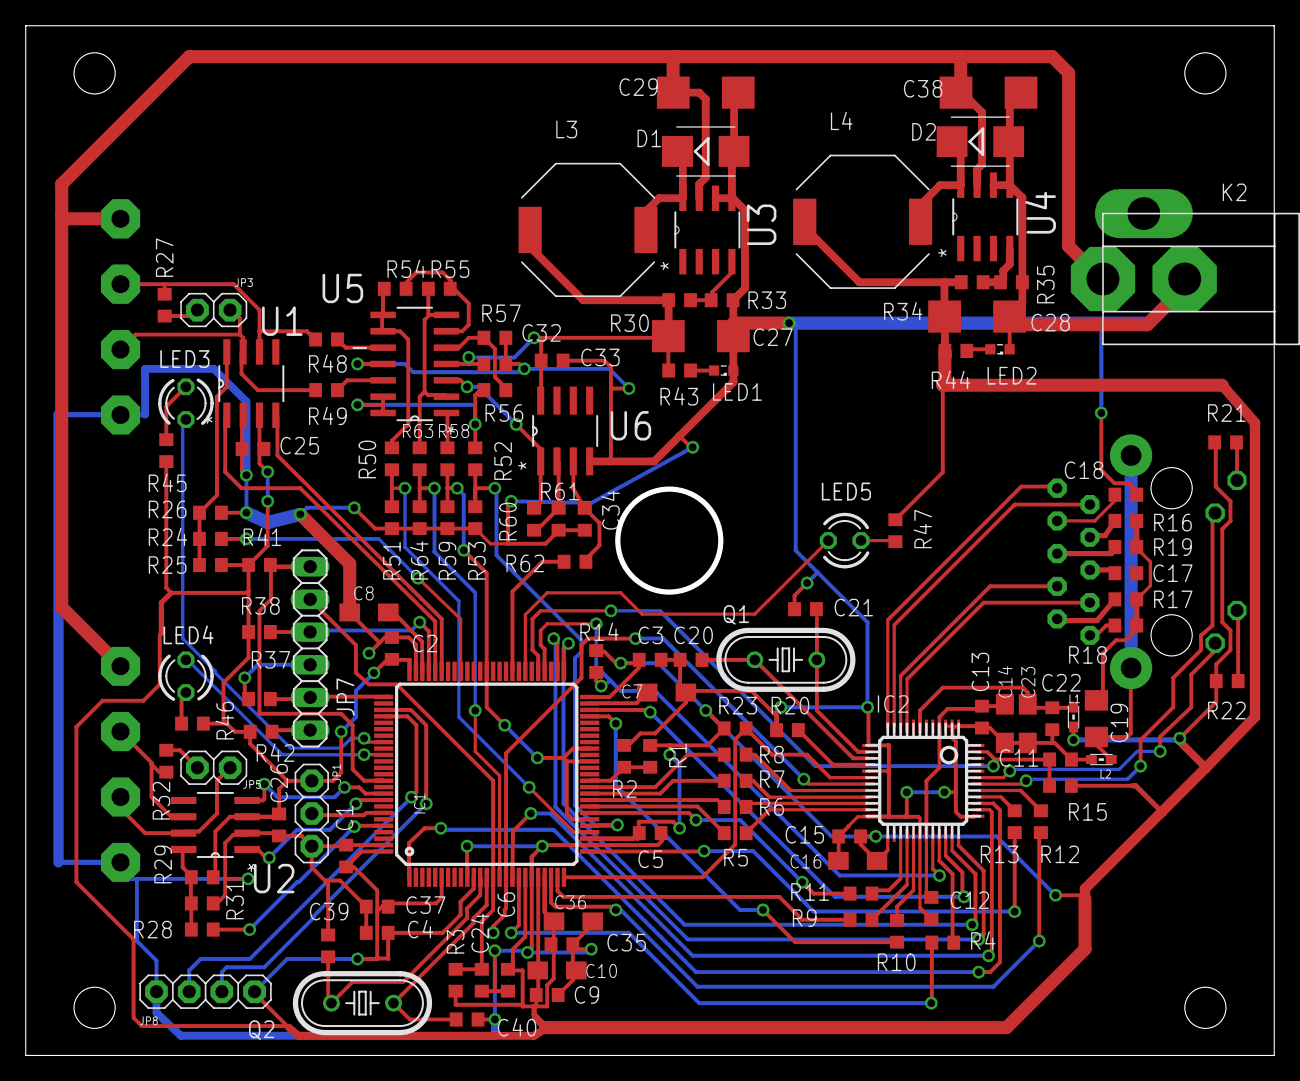
[picture p8: board CanShark.brd from above]

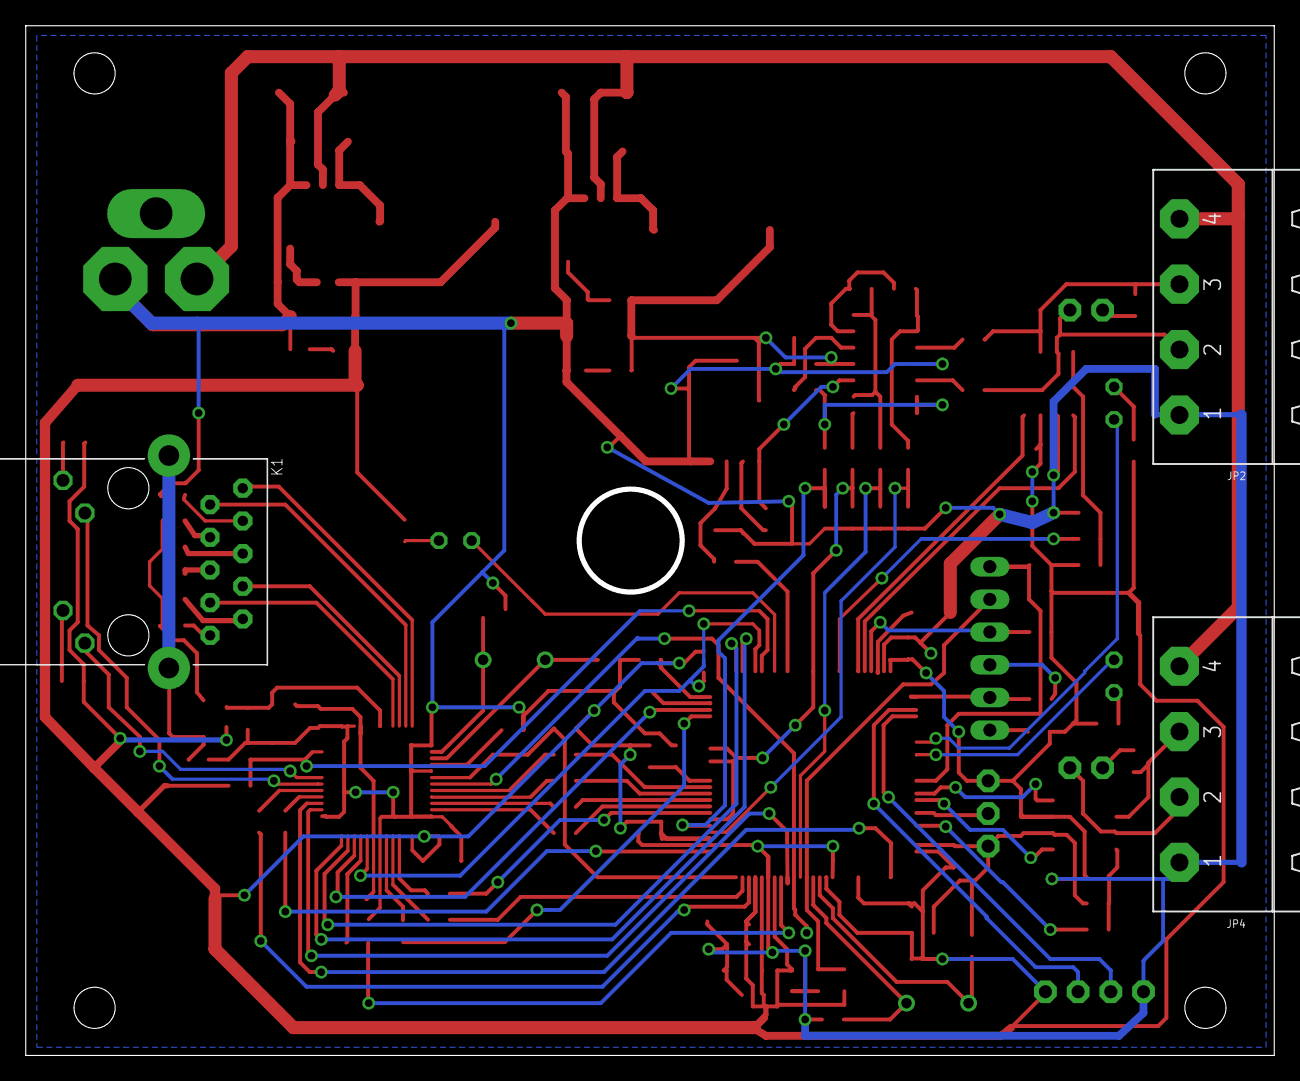
[picture p9: board CanShark.brd from below]

Board: 2 copper layers, 97.0 x 80.0 mm, 129 parts (3 on the bottom side), 109 nets.
