uamt-brno/canshark/fw/boardtest/src/main.cpp

/*
 * This file is part of the canshark project.
 *
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
 * You should have received a copy of the GNU Lesser General Public License
 * along with this library.  If not, see <http://www.gnu.org/licenses/>.
 */

#include <libopencm3/stm32/rcc.h>
#include <libopencm3/cm3/systick.h>

#include "clock.h"
#include "io.h"
#include "board.h"
#include "serial.h"
#include "systick.h"
#include "bxcan.h"

extern "C"
{
	bool ksz8051_nandtree_check(void);
}


#define CHECK(fn, str)	do {					\
		serial_print(str);				\
		serial_print((fn) ? "OK\n" : "FAILED\n");	\
	} while (0)

static void led_init(void)
{
	io_output_high(LED_PIN_CAN1);
	io_output_high(LED_PIN_CAN2);
	io_output_high(LED_PIN_GLOBAL);
}

static bool led_check(void)
{
	io_low(LED_PIN_CAN1);
	//delay 1sec
	io_high(LED_PIN_CAN1);
	io_low(LED_PIN_CAN2);
	//delay 1sec
	io_high(LED_PIN_CAN2);
	io_low(LED_PIN_GLOBAL);
	//delay 1sec
	io_high(LED_PIN_GLOBAL);
	return true;
}

static void phy_init()
{
	rcc_periph_clock_enable(RCC_ETHMAC);
	rcc_periph_clock_enable(RCC_ETHMACPTP);
	rcc_periph_clock_enable(RCC_ETHMACRX);
	rcc_periph_clock_enable(RCC_ETHMACTX);
}

int main(void)
{
	rcc_clock_setup_hse_3v3(&clock_168m_25m);

	/* Initialize pins */
	rcc_periph_clock_enable(RCC_GPIOA);
	rcc_periph_clock_enable(RCC_GPIOB);
	rcc_periph_clock_enable(RCC_GPIOC);
	rcc_periph_clock_enable(RCC_GPIOD);
	rcc_periph_clock_enable(RCC_GPIOE);

	/* Initialize used peripherals */
	systick_init();
	led_init();
	serial_init();

	serial_print("CanShark v2.0 Board test.\n");

	CHECK(led_check(), "Checking LEDs ...");
	CHECK(bxcan_nandtree_check(), "Checking CAN connections ...");
	CHECK(ksz8051_nandtree_check(), "Checking PHY connections ...");

	serial_print("Measuring CAN driver delays: Fast mode ...\n");

	io_low(PCAN1_PIN_MODE);
	io_low(PCAN2_PIN_MODE);
	bxcan_measure_delays();

	serial_printf("CAN1: Thl=%ldns Tlh=%ldns\n", bxcan1_delay.thl, bxcan1_delay.tlh);
	serial_printf("CAN2: Thl=%ldns Tlh=%ldns\n", bxcan2_delay.thl, bxcan2_delay.tlh);

	serial_print("Measuring CAN driver delays: Slow mode ...\n");
	io_input_pulldown(PCAN1_PIN_MODE);
	io_input_pulldown(PCAN2_PIN_MODE);
	bxcan_measure_delays();

	serial_printf("CAN1: Thl=%ldns Tlh=%ldns\n", bxcan1_delay.thl, bxcan1_delay.tlh);
	serial_printf("CAN2: Thl=%ldns Tlh=%ldns\n", bxcan2_delay.thl, bxcan2_delay.tlh);

	phy_init();
	bxcan_init();

	/* Test MAC broadcast storm */
	while (1);

	return 0;
}
