uamt-brno/canshark/fw/boardtest/src/ksz8051.c

#include "io.h"
#include "board.h"

static const uint32_t nand_pins[] = {
	MII_PIN_MDIO, MII_PIN_MDC, MII_PIN_RXD3, MII_PIN_RXD2, MII_PIN_RXD1,
	MII_PIN_RXD0, MII_PIN_RXDV, MII_PIN_RXC, MII_PIN_RXER, MII_PIN_INTRP,
	MII_PIN_TXC, MII_PIN_TXEN, MII_PIN_TXD0, MII_PIN_TXD1, MII_PIN_TXD2,
	MII_PIN_TXD3, MII_PIN_COL
};
static const uint32_t N = sizeof(nand_pins)/sizeof(uint32_t);

bool ksz8051_nandtree_check(void);

/** \brief Check connection between chips
 *
 * \return true if the connection between chips is OK
 */
bool ksz8051_nandtree_check(void)
{
	/* reset the controller and switch to nand tree mode */
	io_output_low(MII_PIN_RST);
	io_output_low(MII_PIN_INTRP);
	// short delay
	io_high(MII_PIN_RST);
	// delay

	/* prepare all pins to NAND tree test */
	for (uint32_t i = 0; i < N; i++) {
		io_output_high(nand_pins[i]);
	}
	io_input(MII_PIN_CRS);

	// delay

	/* process the NAND tree test on CRS (PA0) */
	uint32_t nandtree = io_is_set(MII_PIN_CRS) ? 1 : 0;
	for (uint32_t i = 0; i < N; i++, nandtree <<= 1) {
		io_low(nand_pins[i]);
		nandtree |= io_is_set(MII_PIN_CRS) ? 1 : 0;
		// short delay
	}

	/* reset the controller and switch back to the normal mode */
	io_low(MII_PIN_RST);
	io_high(MII_PIN_INTRP);
	io_af(MII_PIN_CRS, MII_AF);
	for (uint32_t i = 0; i < N; i++) {
		io_af(nand_pins[i], MII_AF);
	}

	// delay

	io_high(MII_PIN_RST);
	return (nandtree == 0b10101010101010101);
}
