uamt-brno/canshark/(commit log)

2013-09-18 [DISSECTOR] Rename the file to meet the board
2013-09-18 [FW] Added version working on F417 board
2013-09-20 Add support for displaying Transmitted frames, corrected timing, utilized ethernet packet to have multiple frames in it (maximum of 256 bytes)
    [main.c, modcan.c, modcan.h, stick.c, stick.h]
2014-02-09 Correct the timestamp display.
    [stick.c]
2014-02-09 Switched to the new lib
2014-05-07 [pcb] Merged all modifications to pcb from Jakub Skalicky
    board manufactured version 1.0
    [CanShark.brd, CanShark.sch]
2014-05-14 [pcb] change mounting hole position, increase the isolation gap
    [CanShark.brd]
2014-06-02 [pcb] change texts of PCB
    [CanShark.brd, CanShark.sch]
2014-06-02 [fw]Change pinout for CanShark board, add prescaler to main LED toggle
    (removed some unnecessary definitions. Cleaned code.)
2014-06-02 [sw/canshark-gui] Add CanBusHistogram class
2014-06-05 [pcb] New PCB layout CanShark v2.0
    This layout has been based on Jakub Skalicky's V10 layout.
    The main differences are:
    * Size of the board truncated to be fabricated in ITEAD studio.
    * Power supply scheme changed, only power from application is enabled.
    * Removed analog measurement because it was currently not used in software
    * Added synchronization port (possible input or output with TTL 3.3V level to trig scope meter)
    * Hammond plastic box can be used.
    [CanSharkV20.brd, CanSharkV20.sch]
2014-07-02 [fw] Board testing firmware added. No tests currently valid
2014-07-02 [fw/boardtest] cleaning
2014-07-02 [fw/boardtest] Style check for C++ and C,
2014-07-02 [fw/test] Board test preliminary work
2014-07-02 [fw/test] Make pinout definitions through board
2014-07-07 [fw/boardtest] Add CAN physical driver delay measurement
2014-07-14 [sw/gui] Fully implement the new analysis data flow.
2014-07-14 [sw/gui] Populate objects to easily parse and print ObjectID's
2014-07-14 [sw/gui] Raise receiving thread priority
2014-07-14 [sw/gui] Refactoring boards to its own directorz and namespace
